pruettfed/McLaren-Control-System/documentation/images/part-design.jpg

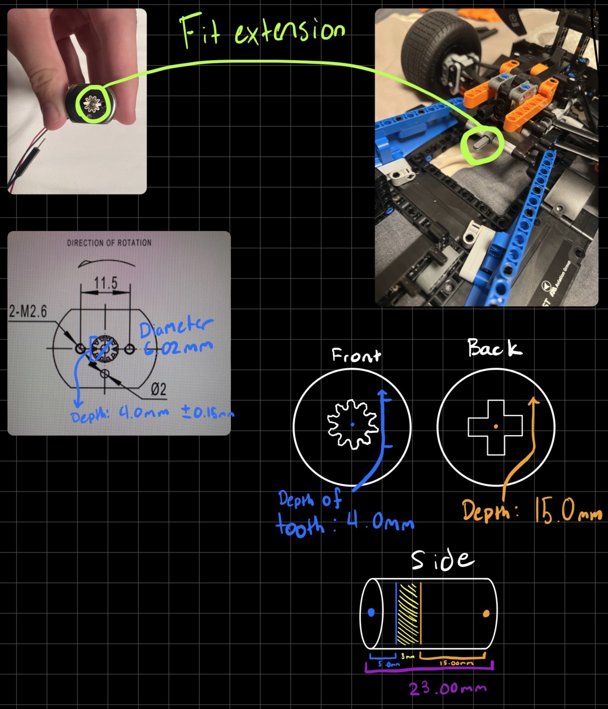
documentation/images/part-design.jpg
