pruettfed/McLaren-Control-System/documentation/models/Lego Motor Connector v10.stl

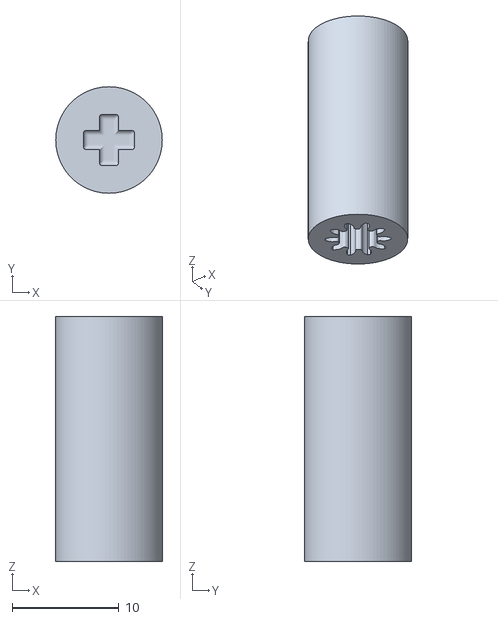
[picture p14: CAD file, 2023-03-23]
documentation/models/Lego Motor Connector v10.stl
10.0 x 10.0 x 23.0
