pruettfed/McLaren-Control-System/documentation/models/Motor Holder v5.stl

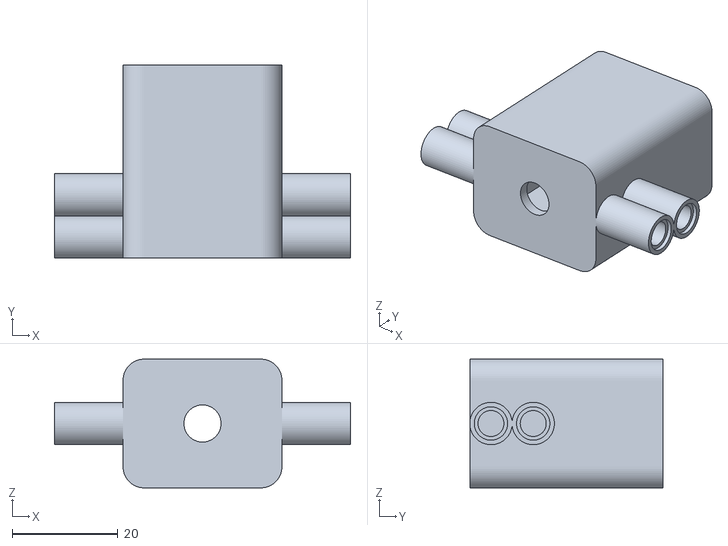
[picture p15: CAD file, 2023-03-23]
documentation/models/Motor Holder v5.stl
55.8 x 36.5 x 24.3
