pruettfed/McLaren-Control-System/(commit log)

2023-01-05 [v0.2.0] - Updated pin mappings
2023-03-23 [v0.3.0] - Updated README and added images
    [Lego Motor Connector v10.stl, Motor Holder v5.stl]
